bhamiltoncx/lorenzo-il-magnifico-insert/(list of files, cad)

Other CAD files:
boardgame_insert_toolkit_lib.2.scad
