bhamiltoncx/lorenzo-il-magnifico-insert/(commit log)

2026-09-06 Import original Lorenzo Il Magnifico insert design
    Vendors the design and the BIT v2.45 library exactly as published, with
    no modifications, so that subsequent fixes show up as reviewable diffs.
    Source: https://www.printables.com/model/340905-lorenzo-il-magnifico-insert
    License: CC BY-NC-SA 4.0
    Claude-Session: https://claude.ai/code/session_01JEMiMcZgM6p7oSLyVEDVwt
    [Lorenzo.scad, boardgame_insert_toolkit_lib.2.scad]
2026-09-06 fix: enlarge Expansion V3 family tile compartment to fit the tiles
    The family tile compartment measured 57 x 66.5mm but the tiles measure
    57.14 x 67.5mm, so they do not fit on either axis. Other people printing
    remixes of this design have reported the same problem.
    There was 5mm of unused space to the right of the compartment but only
    1mm behind it, so the compartments sharing its row had to move:
    Family Tiles CMP_COMPARTMENT_SIZE_XYZ [57, 66.5, 13] -> [58.5, 68.5, 13]
    Faith Tiles CMP_COMPARTMENT_SIZE_XYZ [89, 46, 14] -> [89, 45, 14]
    Faith Tiles POSITION_XY [68, 68.5] -> [68, 70.5]
    Brown Pawn POSITION_XY [158, 68.5] -> [158, 70.5]
    The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
    [Lorenzo.scad]
2026-09-06 feat: label every lid in EB Garamond Italic
    Each lid now carries its contents name on a raised plaque. EB Garamond
    Italic was chosen because it closely matches the calligraphic lettering
    on the game's own cover.
    Google ships EB Garamond as a variable font, and OpenSCAD 2021.01 cannot
    select a variable axis at render time -- asking for a weight it has no
    static face for silently returns a synthesized substitute rather than
    failing. So the weight is pinned ahead of time: scripts/make-font-instance.py
    bakes a static instance at weight 450 and renames the family to
    "EB Garamond Insert", both to disambiguate it from a system-installed
    EB Garamond and because a 450-weight instance is not stock EB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
    [Lorenzo.scad]
2026-09-06 fix: don't surface OpenSCAD's Fontconfig warning as a build error
    OpenSCAD emits "Fontconfig warning: ... unknown element blank" from its
    bundled fonts.conf on every run. It is harmless, but build.sh's filter
    matched on WARNING and printed it alongside real errors, making a clean
    build look like a failing one.
    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
2026-09-06 fix: repair non-manifold edge in the Expansion lid, and check for it
    Bambu Studio rejected the Expansion lid from v1.1.0 with "1 non-manifold
    edge". Auditing the mesh found exactly one edge shared by four triangles
    rather than two, at local (148.48, 42.77) -- the label plaque's frame
    boundary landing precisely tangent to a lid perforation.
    The cause was the label, not the toolchain. Building the pre-label design
    on the same OpenSCAD produces a clean mesh, and the other seven labelled
    lids are clean; only this text at this size on this lid hits the tangency.
    It is a knife edge: every perturbation tried resolved it (plaque margins
    of 1.6/1.8/2.2/2.5/3.0, and label offsets of 1mm in either ax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
    [Lorenzo.scad]
2026-09-06 fix: make lid labels and plaque stripes printable on a 0.4mm nozzle
    A printed Development Cards lid came back with the plaque stripes snapped
    and the lettering peeled off the bed. Two independent causes, both from
    features narrower than a single extrusion.
    The plaque's 45 degree stripes are drawn at LID_STRIPE_WIDTH (default 0.5)
    and only half the lid's 1mm thickness, in the upper half, over a region
    where the lattice has been cut away. Each one therefore bridges roughly
    24mm of open air as a lone 0.5 x 0.5mm bar. Widening them to 1.2mm with a
    0.8mm gap gives three lines abreast, which bridges.
    The lettering is worse than it looks. LBL_SIZE AUTO caps at 100mm wide no
    matter how long the li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
    [Lorenzo.scad]
